paperdink/paperd.ink/README.md

<p align="center">
  <br/>
  
  <br/>
  
</p>

# paperd.ink - pretty & powerful

paperd.ink is a 4.2″ e-paper (like e-ink) development board powered by an ESP32 module. You have the freedom to customize since paperd.ink is open-source. For starters, you can sync calendars, set up your home IoT dashboard, get to-do lists, notifications, display images, and much more. The beautiful e-paper allows you to get rid of all distractions and work peacefully.

Visit [paperd.ink](https://paperd.ink) to know more.
