paperdink/paperd.ink/Mechanical/rev2/rev2_stand.stp

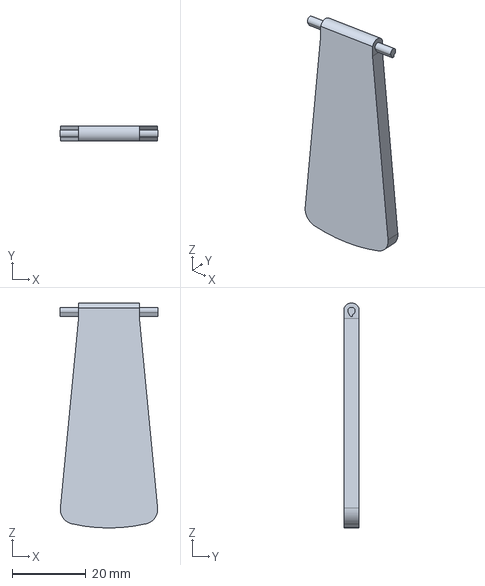
[picture p1: CAD file, 2021-04-02, last stored version]
Mechanical/rev2/rev2_stand.stp
26.5 x 4.00 x 61.0 mm
