paperdink/paperd.ink/Mechanical/rev2/rev_2_back_cover.stp

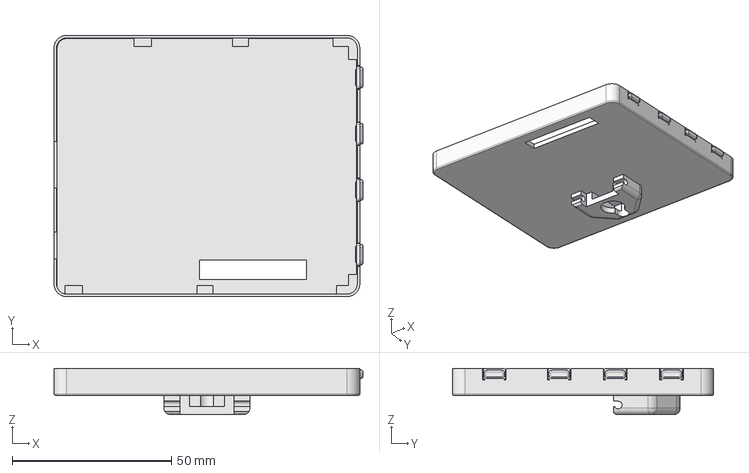
[picture p2: CAD file, 2021-04-02, last stored version]
Mechanical/rev2/rev_2_back_cover.stp
97.1 x 82.1 x 14.5 mm
