paperdink/paperd.ink/Mechanical/rev2/rev_2_front_cover.stp

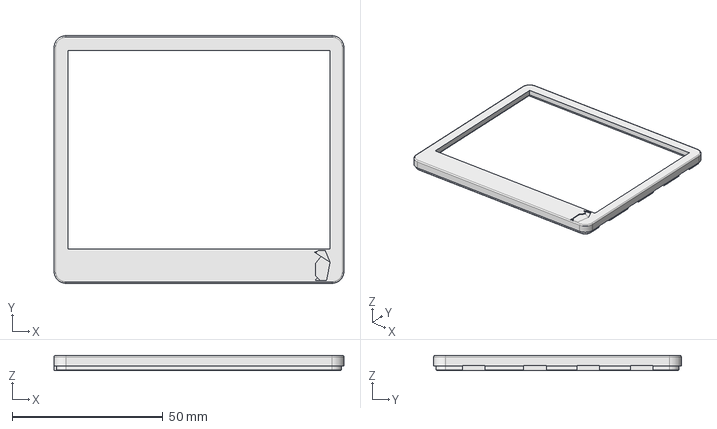
[picture p3: CAD file, 2021-04-02, last stored version]
Mechanical/rev2/rev_2_front_cover.stp
96.1 x 82.1 x 5.00 mm
