paperdink/paperd.ink/Mechanical/rev1/Main_PCB.stl

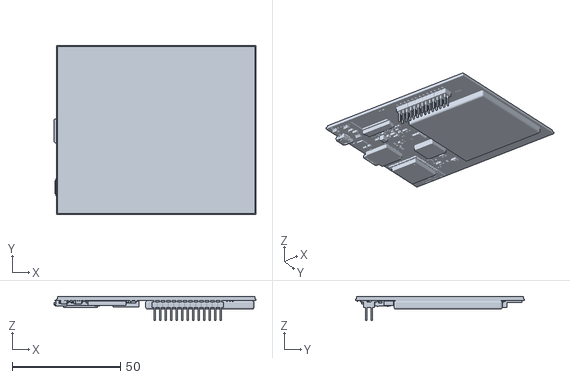
[picture p4: CAD file, 2020-01-05, an earlier design]
Mechanical/rev1/Main_PCB.stl
93.1 x 78.1 x 11.3
