paperdink/paperd.ink/Electronics/rev2/Output/DXF/paperd.ink.dxf

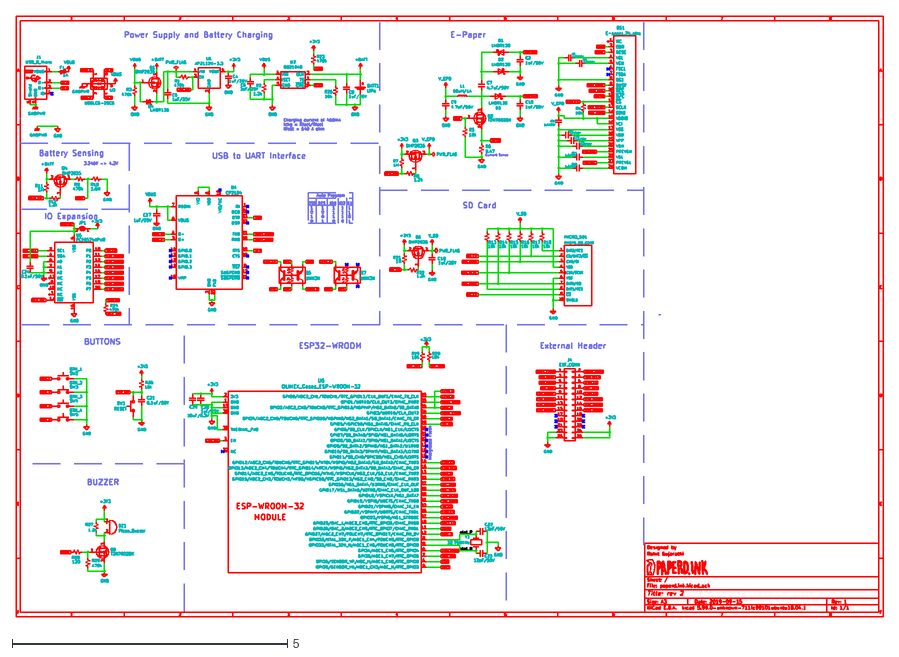
[picture p5: CAD file, 2020-11-08, an earlier design]
Electronics/rev2/Output/DXF/paperd.ink.dxf
15.7 x 10.9
