paperdink/paperd.ink/Mechanical/rev1/Back_Enclosure.stl

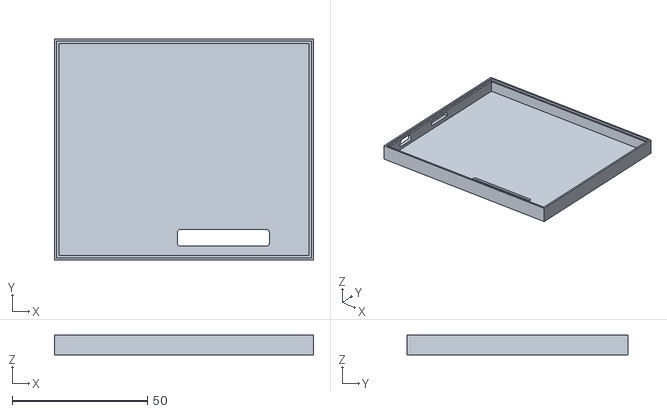
[picture p6: CAD file, 2020-01-28, an earlier design]
Mechanical/rev1/Back_Enclosure.stl
95.8 x 81.8 x 7.25
