paperdink/paperd.ink/Mechanical/rev1/Front_Enclosure.stl

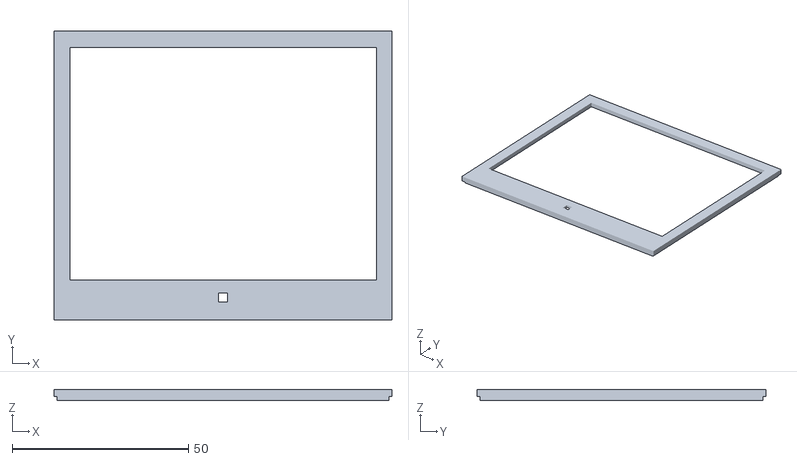
[picture p7: CAD file, 2020-01-28, an earlier design]
Mechanical/rev1/Front_Enclosure.stl
95.8 x 81.8 x 2.99
