paperdink/paperd.ink/Mechanical/rev1/Front_Panel_PCB.stl

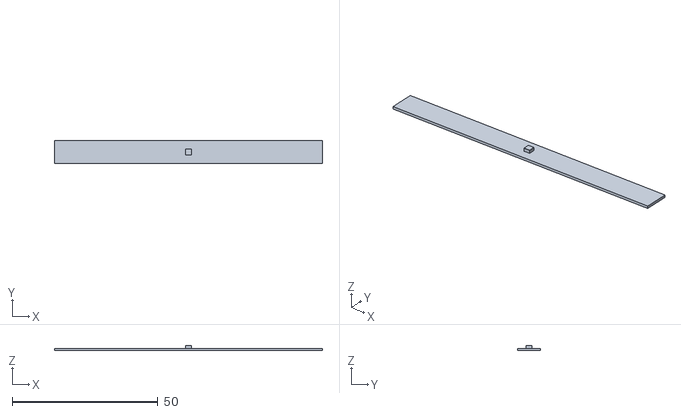
[picture p8: CAD file, 2020-01-05, an earlier design]
Mechanical/rev1/Front_Panel_PCB.stl
92.1 x 8.00 x 1.80
