paperdink/paperd.ink/(list of files, cad)

Other CAD files:
Electronics/rev1/Output/DXF/paperd.ink_main_pcb-B_SilkS.dxf
Electronics/rev1/Output/DXF/paperd.ink_main_pcb-F_SilkS.dxf
Electronics/rev2/Output/DXF/paperd.ink_main_pcb-B_SilkS.dxf
Electronics/rev2/Output/DXF/paperd.ink_main_pcb-F_SilkS.dxf
Mechanical/rev2/rev2_stand.stl
Mechanical/rev2/rev_2_back_cover.stl
Mechanical/rev2/rev_2_front_cover.stl
