paperdink/paperd.ink/Hardware/rev1/kicad/KaroDesk_V1.kicad_pcb

## KiCad design Hardware/rev1/kicad/KaroDesk_V1.kicad_pcb (2019-12-16, an earlier design)

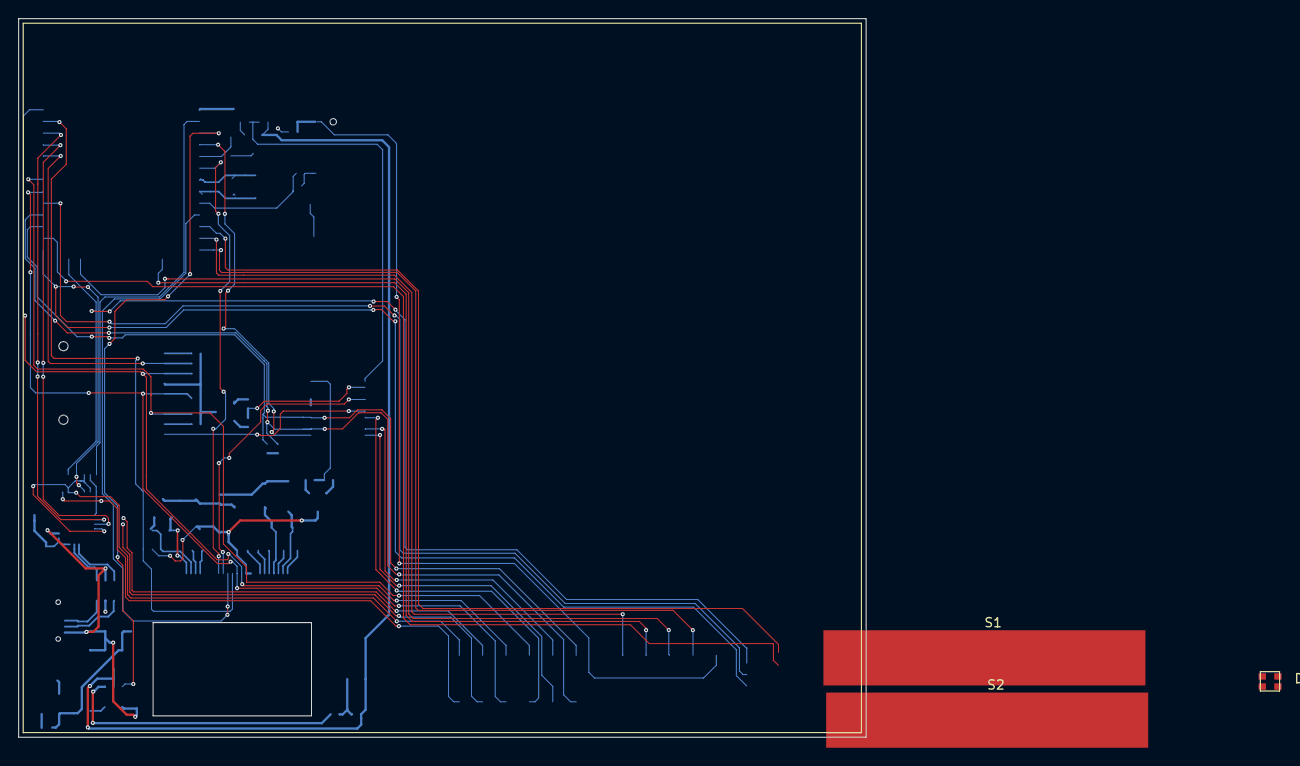
[picture p11: board KaroDesk_V1.kicad_pcb from above]

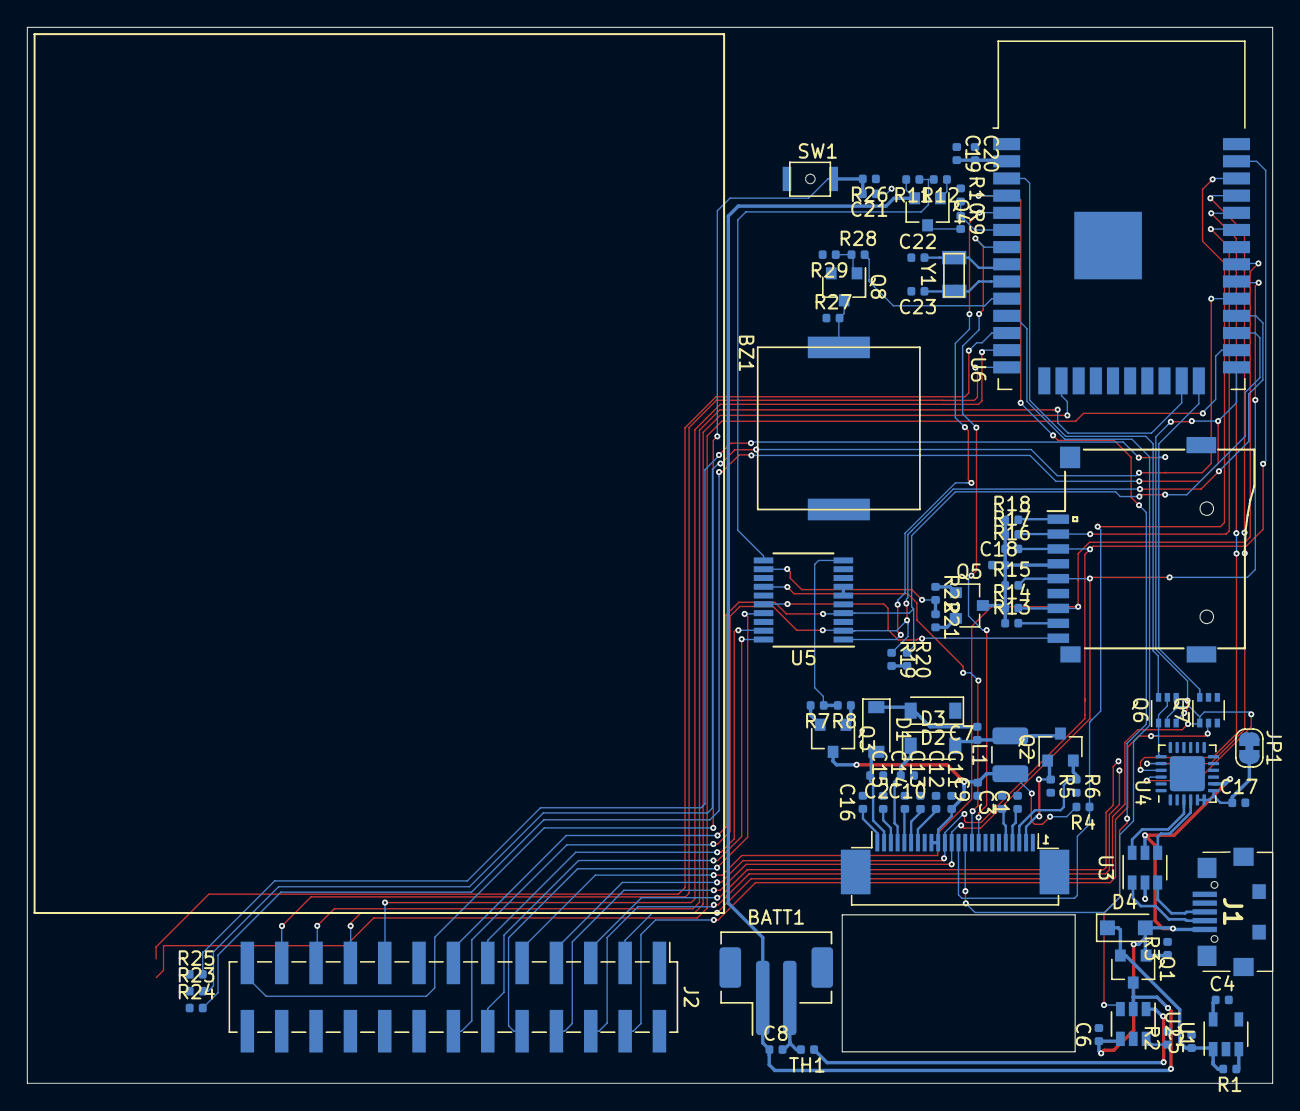
[picture p12: board KaroDesk_V1.kicad_pcb from below]

Board: 4 copper layers, 92.1 x 78.1 mm, 84 parts (80 on the bottom side), 76 nets.

Parts:
BATT1: LiPo; JST_PH_B2B-PH-SM4-TB_1x02-1MP_P2.00mm_Vertical
BZ1: Piezo_Buzzer; KLJ-1230
C1, C2, C3, C10, C11, C12, C13, C14, C15, C16: 1uF/25V; C_0402_1005Metric
C4, C5, C6, C8, C18, C20: 1uF; C_0402_1005Metric
C7: 4.7uF/25V; C_0402_1005Metric
C9: 10uF/25V; C_0402_1005Metric
C17, C19: 10uF; C_0402_1005Metric
C21: 0.1uF/25V; C_0402_1005Metric
C22, C23: 12pF; C_0402_1005Metric
D1, D2, D3: MBR0530; D_SOD-123
D4: MBR120 1A/20V; D_SOD-123F
D5: FM-B2020RGBA-HG
DS1: E-paper_24_pins; 4.2_inch_e_paper_bottom_layer
J1: USB_B_Micro; C77238
J2: EXT_CONN; PinHeader_2x13_P2.54mm_Vertical_SMD
JP1: SolderJumper_2_Bridged; SolderJumper-2_P1.3mm_Bridged_RoundedPad1.0x1.5mm
L1: 68uH/1A; L_1210_3225Metric
MICRO_SD1: micro_sd_card; micro_SD_card
Q1, Q3, Q4, Q5: DMP2035; SOT-23
Q2, Q8: T2N7002BK; SOT-23
Q6, Q7: UMH3N; SOT-363_SC-70-6
R1, R3, R29: 100k; R_0402_1005Metric
R2: 2.7k; R_0402_1005Metric
R4, R5, R13, R14, R15, R16, R17, R18, R19, R20, R26: 10k; R_0402_1005Metric
R6: 0.47; R_0402_1005Metric
R7, R11, R21: 1M; R_0402_1005Metric
R8, R12, R22, R27: 1k; R_0402_1005Metric
R9: 470k; R_0402_1005Metric
R10: 1.6M; R_0402_1005Metric
R23, R24, R25: 120; R_0402_1005Metric
R28: 100; R_0402_1005Metric
S1: CAPBTN1; cap_touch_35x6
S2: CAPBTN2; cap_touch_35x6
SW1: RESET; K2-1822SA-A3DW-06
TH1: 10K NTC; R_0402_1005Metric
U1: AP2112K-3.3; SOT-23-5
U2: BQ21040; SOT-23-6
U3: USBLC6-2SC6; SOT-23-6
U4: CP2104; QFN-24-1EP_4x4mm_P0.5mm_EP2.6x2.6mm
U5: PCF8574APWR; TSSOP-20_4.4x6.5mm_P0.65mm
U6: OLIMEX_Cases_ESP-WROOM-32; ESP32-WROOM-32
Y1: 32.768KHz; Q13FC1350000400

Connections:
+3V3: BZ1.1, C4.1, C19.2, C20.2, D5.3, J2.2, J2.16, J2.18, JP1.1, Q3.2, Q5.2, R7.2, R19.2, R20.2, R21.2, R26.1, R27.1, U1.5, U5.5, U6.2
+BATT: BATT1.1, C8.1, Q1.3, Q4.2, R11.2, U2.2
/D_N: J1.2, U3.1
/D_P: J1.3, U3.3
/xtal_N: C23.1, U6.9, Y1.1
/xtal_P: C22.2, U6.8, Y1.2
BATT: R9.1, R10.2, U6.6
BUZZ: R28.2, U6.10
CAPBTN_1: S1.1, U6.26
CAPBTN_2: S2.1, U6.12
DTR: J2.3, Q6.2, Q6.4, Q7.1, U4.22
EPD_BUSY: DS1.9, U6.7
ESP_EN: C21.2, J2.25, Q6.6, R26.2, SW1.2, U6.3
EXT_GPIO0: J2.10, U5.17
EXT_GPIO1: J2.11, U5.19
EXT_GPIO2: J2.12, U5.20
GDR: DS1.2, Q2.1, R5.1
GND: BATT1.2, C1.2, C2.1, C3.2, C4.2, C5.2, C6.2, C8.2, C9.1, C10.1, C11.1, C12.2, C13.2, C14.2, C15.2, C16.2, C17.2, C18.1, C19.1, C20.1, C21.1, C22.1, C23.2, D2.1, DS1.8, DS1.17, J1.5, J1.6, J2.1, J2.15, J2.20, J2.22, J2.26, MICRO_SD1.6, MICRO_SD1.10, Q8.2, R2.2, R3.2, R5.2, R6.2, R10.1, R29.2, SW1.1, TH1.2, U1.2, U2.5, U3.2, U4.2, U4.25, U5.6, U5.7, U5.9, U5.15, U6.1, U6.15, U6.38, U6.39
GPIO_0: Q6.3, R24.2, U6.25
GPIO_2: Q7.6, R25.2, U6.24
I2C_SCL: J2.14, R19.1, U5.2, U6.28
I2C_SDA: J2.13, R20.1, U5.4, U6.27
JTAG_TCK: J2.19, U6.16
JTAG_TDI: J2.23, U6.14
JTAG_TDO: J2.21, U6.23
JTAG_TMS: J2.17, U6.13
unnamed: BZ1.2, Q8.3, R27.2
unnamed: C1.1, DS1.4
unnamed: C3.1, DS1.5
unnamed: C5.1, D4.1, Q1.2, R1.2, U1.1
unnamed: C7.1, D3.2, L1.2, Q2.3
unnamed: C7.2, D1.1, D2.2
unnamed: C12.1, DS1.18
unnamed: C13.1, DS1.19
unnamed: C14.1, DS1.20
unnamed: C15.1, DS1.22
unnamed: C16.1, DS1.24
unnamed: C17.1, JP1.2, U4.5, U4.6, U4.7
unnamed: D5.1, R23.1
unnamed: D5.2, R25.1
unnamed: D5.4, R24.1
unnamed: MICRO_SD1.1, R18.2
unnamed: MICRO_SD1.8, R13.2
unnamed: Q3.1, R8.1
unnamed: Q4.1, R12.1
unnamed: Q4.3, R9.2
unnamed: Q5.1, R22.1
unnamed: Q8.1, R28.1, R29.1
unnamed: R1.1, U1.3
unnamed: R2.1, U2.6
unnamed: TH1.1, U2.1
PREVGH: C10.2, D3.1, DS1.21
PREVGL: C2.2, D1.2, DS1.23
RESE: DS1.3, Q2.2, R6.1
RTS: J2.4, Q6.1, Q6.5, Q7.2, U4.19
SPI_MISO: J2.9, MICRO_SD1.7, R14.2, U6.31
SPI_MOSI: DS1.14, J2.7, MICRO_SD1.3, R16.2, U6.37
SPI_SCLK: DS1.13, J2.8, MICRO_SD1.5, R15.2, U6.30
UART_RXD0: J2.6, U4.21, U6.34
UART_TXD0: J2.5, U4.20, U6.35
USB_N: U3.4, U4.4
USB_P: U3.6, U4.3
VBUS: C6.1, D4.2, J1.1, Q1.1, R3.1, U2.4, U3.5, U4.8
V_EPD: C9.2, C11.2, DS1.15, DS1.16, L1.1, Q3.3, R4.2
V_SD: C18.2, MICRO_SD1.4, Q5.3, R13.1, R14.1, R15.1, R16.1, R17.1, R18.1
~BATT_EN: R11.1, R12.2, U5.11
~CHG: U2.3, U6.4
~EPD_CS: DS1.12, R4.1, U6.36
~EPD_DC: DS1.11, U6.11
~EPD_EN: R7.1, R8.2, U5.10
~EPD_RES: DS1.10, U5.14
~LED_R: R23.2, U6.29
~PCF_INT: U5.1, U6.5
~SD_CD: MICRO_SD1.9, U5.16
~SD_CS: MICRO_SD1.2, R17.2, U6.33
~SD_EN: R21.1, R22.2, U5.12
