paperdink/paperd.ink/Electronics/rev2/paperd.ink_front_pcb.kicad_pcb

## KiCad design Electronics/rev2/paperd.ink_front_pcb.kicad_pcb (2020-06-09, an earlier design)

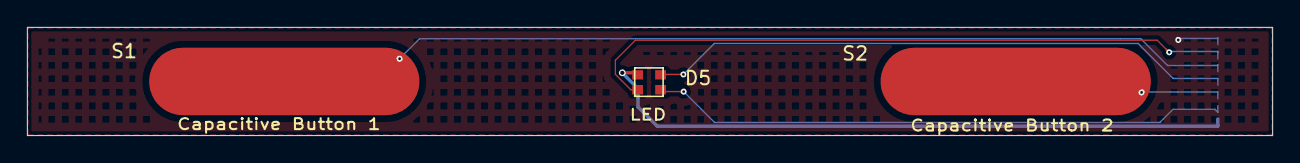
[picture p13: board paperd.ink_front_pcb.kicad_pcb from above]

Board: 4 copper layers, 92.1 x 8.0 mm, 4 parts (1 on the bottom side), 7 nets.

Parts:
D5: FM-B2020RGBA-HG
J2: Conn_01x14; FPC_14P_0.5mm
S1: CAPBTN1; cap_touch_35x6
S2: CAPBTN2; cap_touch_35x6

Connections:
FPC_3V3: D5.3, J2.1, J2.2
FPC_CAPBTN_1: J2.9, J2.10, S1.1
FPC_CAPBTN_2: J2.5, J2.6, S2.1
FPC_GND: J2.13, J2.14
~FPC_LED_B: D5.2, J2.11, J2.12
~FPC_LED_G: D5.4, J2.7, J2.8
~FPC_LED_R: D5.1, J2.3, J2.4
