paperdink/paperd.ink/(threads)

Thread 2 (2020-03-25):

Does not open in the latest version of kicad?

ketan, 2020-03-25:
Hi:

Thanks for this great project. I'm attempting to use some aspects of this to build a variometer, by adding an IMU and BMP sensor to this project, and maybe a different paper display and maybe a slightly different form factor.

Could you clarify what version of kicad you're using and where I can grab that version? I'm unable to load this on the latest stable kicad 5.1.5.

rgujju, 2020-03-25:
Hi Ketan,

You will require the nightly build of kicad to open it.

Closed 2020-03-25.

Thread 3 (2020-06-08):

Change CP2104 to be powered completely from USB

rgujju, 2020-06-08:
To change the CP2104 to bus powered application:
-     Disconnect VDD (pin6) to 3.3V connection
-     Connect REGIN (7) to VBUS (8)
-     Check datasheet for capacitors
-     VIO should still be connected to 3.3V for setting I/O voltage

Closed 2020-10-31.

Thread 4 (2020-06-08):

Change voltage regulator to one with a lower quiescent current

rgujju, 2020-06-08:
The quiescent current seems quite high for this LDO. Replace it with a better one.

rgujju, 2020-12-19:
Selected XC6220B331MR-G

Closed 2020-12-19.

Thread 5 (2020-06-08):

Change the battery charger schematic symbol

rgujju, 2020-06-08:
Battery charger symbol is wrong hence the connections to it are wrong

Closed 2020-10-31.

Thread 6 (2020-06-08):

Mechanical changes

rgujju, 2020-06-08:
Make depression for touch pads
Make front panel cut out deeper
Better snap fit
Add PCB leveler/support on the bottom side
Make USB connector pop out
Add hole for reset button

Closed 2021-04-03.

Thread 7 (2020-06-08):

Add ability to reset WiFi credentials and API keys

rgujju, 2020-06-08:
To reset the WiFi credentials and API keys we need to remove the file from flash by overwriting it from the arduino IDE.
Add support to remove it from the paperd.ink UI itself

Thread 10 (2021-08-19):

Corrupt project files.

3tch-a-sketch, 2021-08-19:
It appears that the files in the rev2 project cannot be opened (board and schematic). And only the schematic in the rev 1 can be opened.

Using kicad 5.1.10 release build

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

3tch-a-sketch, 2021-08-19:
Fixed by using kicad nightly as previously mentioned in another issue.

Closed 2021-08-19.

Thread 11 (2022-07-26):

Not showing up as a com port...

kcorey, 2022-07-26:
Hi All,

I've got two computers (a Mac and a PC).
Mac: MacOS 12.4, Arduino IDE 1.8.13
Windows: Latest OS, Arduino 1.8.19, drivers have been installed.

Neither computer sees the paperd being plugged into the USB port, which means that a COM port is never created.

Is there a way to factory reset the paperd, or is this one just bricked?

Could it be unbricked by loading something onto the SD card?

rgujju, 2022-07-26:
Hello,
The paperd.ink should not get bricked. Have you tried with a different USB cable? Some USB cables don't have the data lines connected which causes such issues.

kcorey, 2022-07-27:
Thanks very much for writing Rohit!

It was, in fact, the USB cable.  I was surprised because I tried two computers and two USB cables, but apparently both of them were power-only.  They've been disposed of!

I've now got my paperd working from either my Mac or my PC.

Closed 2022-07-27.
