paperdink/paperd.ink/(commit log)

2019-10-06 Added PCB Design files
2019-10-06 Changed Capacitor values to 50V
2019-12-16 Added all project files
    [ESP32.xlsx, KaroDesk_V1.0.kicad_pcb, KaroDesk_V1.kicad_pcb, KaroDesk_V1.sch, KaroDesk_V1_4layers.kicad_pcb]
2019-12-22 Added BOM
    [KaroDesk_V1.csv]
2020-01-05 Added 3D model
    [Back_Enclosure.stl, ESP32_Pinout.xlsx, Front_Enclosure.stl, Front_Panel_PCB.stl, Main_PCB.stl, paperd.ink_BOM.xlsx, paperd.ink_V1.sch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]
2020-01-28 [MECH] Increased wall thickness to 1.6mm
    [Back_Enclosure.stl, Front_Enclosure.stl]
2020-01-28 Reduced current consumption to under 200uA
2020-05-27 Fix for calender not printing properly
2020-06-08 Added rev2 files with latest kicad format
    [Deep_Sleep_CC.xlsx, ESP32_Pinout.xlsx, paperd.ink_BOM.xlsx, paperd.ink_V1.kicad_sch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]
2020-06-09 split PCB into main and front
    [paperd.ink_front_pcb-B_Cu.gbl, paperd.ink_front_pcb-B_Fab.gbr, paperd.ink_front_pcb-B_Mask.gbs, paperd.ink_front_pcb-B_Paste.gbp, paperd.ink_front_pcb-B_SilkS.gbo, paperd.ink_front_pcb-Edge_Cuts.gm1, paperd.ink_front_pcb-F_Cu.gtl, paperd.ink_front_pcb-F_Fab.gbr]
2020-10-31 Completed revision 2. Fixes for #3 #5.
    Simplified design.
    Removed front panel
    Added tactile buttons
    CP2104 powered from bus
    Fixed battery charger schematic and footprint
    GPIO expander only controls external IOs
    Removed JTAG port
    [paperd.ink.kicad_pcb, paperd.ink.kicad_sch, paperd.ink_V1.kicad_sch, paperd.ink_front_pcb.kicad_pcb, paperd.ink_main_pcb.kicad_pcb]
2020-11-08 Cleaned up rev1 files
    [Deep_Sleep_CC.xlsx, ESP32_Pinout.xlsx, paperd.ink_BOM.xlsx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]
2020-11-08 Added pdf, svg, dxf of schematic
    [paperd.ink.dxf]
2020-11-08 Made few changes
    1) Added fuse
    2) Changed battery connector to smaller one since this was too tall
    [paperd.ink.kicad_pcb, paperd.ink.kicad_sch]
2020-11-09 Changed batt connector 3D model
    [paperd.ink.kicad_pcb]
2020-11-20 moved USB connector
    [paperd.ink.kicad_pcb]
2021-04-02 rev2 mechanical files
    [rev2_stand.stp, rev_2_back_cover.stp, rev_2_front_cover.stp]
2021-04-14 Added stl files for rev2
    [rev2_stand.stl, rev_2_back_cover.stl, rev_2_front_cover.stl]
2022-04-13 Added revision 3 files
    [paperd_ink_rev3-B_Cu.gbl, paperd_ink_rev3-B_Fab.gbr, paperd_ink_rev3-B_Mask.gbs, paperd_ink_rev3-B_Paste.gbp, paperd_ink_rev3-B_Silkscreen.gbo, paperd_ink_rev3-Edge_Cuts.gm1, paperd_ink_rev3-F_Cu.gtl, paperd_ink_rev3-F_Fab.gbr]
2022-04-13 Moved electronics and mech to separate repos
    [Back_Enclosure.stl, Deep_Sleep_CC.xlsx, ESP32_Pinout.xlsx, Front_Enclosure.stl, Front_Panel_PCB.stl, Main_PCB.stl, paperd.ink.dxf, paperd.ink.kicad_pcb]
